dmitrykez/ESP_Damper/README.md

# ESP Damper  
## HVAC Damper Controller

This project is designed to monitor and control HVAC dampers using the **TAC-910 protocol**.  
It utilizes the **ESP32-S2-WROOM** microcontroller, which supports up to 4 RMT channels, allowing control of up to **four dampers**.

---

## 🚀 Key Features

- **Parallel Integration**  
  Hardware connects in parallel with an existing TAC-910 controller.  
  This enables the ESP32 to both **listen to IR commands** received by the TAC-910 and **send its own IR commands**.

- **Multi-Channel IR support**  
  Supports up to 4 IR channels simultaneously using the ESP32 RMT peripheral.
  The FW supports dual device operation to support up to 8 channels, seemlees for Home Assistant.

- **Wi-Fi & MQTT Communication**  
  The ESP32 connects to the home network via Wi-Fi and communicates with **Home Assistant** using the **MQTT protocol**.

- **Web-Based Configuration UI**  
  Built-in Web UI accessible via the device IP address:
  Device name (Wi-Fi and MQTT identification)
    - Wi-Fi credentials
    - MQTT broker address and port
    - Channel group selection (0–3 or 4–7)
    - Basic communication status
    - Firmware update (OTA)
    - Factory reset

---

## ⚙️ Operation Overview

- **Startup**  
  On boot, the controller connects to Wi-Fi and the MQTT broker, then enters RX mode to listen for IR commands on all four RMT channels.

- **IR → MQTT**  
  When an IR command is received, it is parsed and published to Home Assistant via MQTT.

- **MQTT → IR**  
  When an MQTT command is received, it’s converted into the appropriate IR format.  
  The relevant RMT channel switches to TX mode, sends the command to the TAC-910, and then returns to RX mode.

- **OTA Firmware Updates**  
  Firmware can be updated over-the-air (OTA) by accessing the controller through its IP address in a web browser.

- **Factory Reset**  
  Factory reset clears all stored user configuration and restarts the device in Wi-Fi Access Point (AP) mode for initial setup.
  Reset methods:
    - Via Web UI
    - By pressing and holding the Reset button for 5 seconds until the status LED blinks at 1-second intervals

---

## 📦 Modules

- **RX**  
  Listens for IR commands on up to 4 channels using the RMT module.

- **TX**  
  Sends IR commands to the TAC-910 via the RMT module.

- **Wireless**  
  Handles Wi-Fi and MQTT connectivity, as well as Web UI and OTA firmware updates.

- **Helpers**  
  Includes functions and defaults for data parsing and command management.

- **EEPROM**  
  Defined but not currently used.

---

## 📝 TODO
- [ ] Utilize EEPROM to:  
  - [ ] Store the last known configuration for each damper channel.  

## 🛠️ Controller view
