dmitrykez/ESP_Damper/ESP32 Damper.pdf

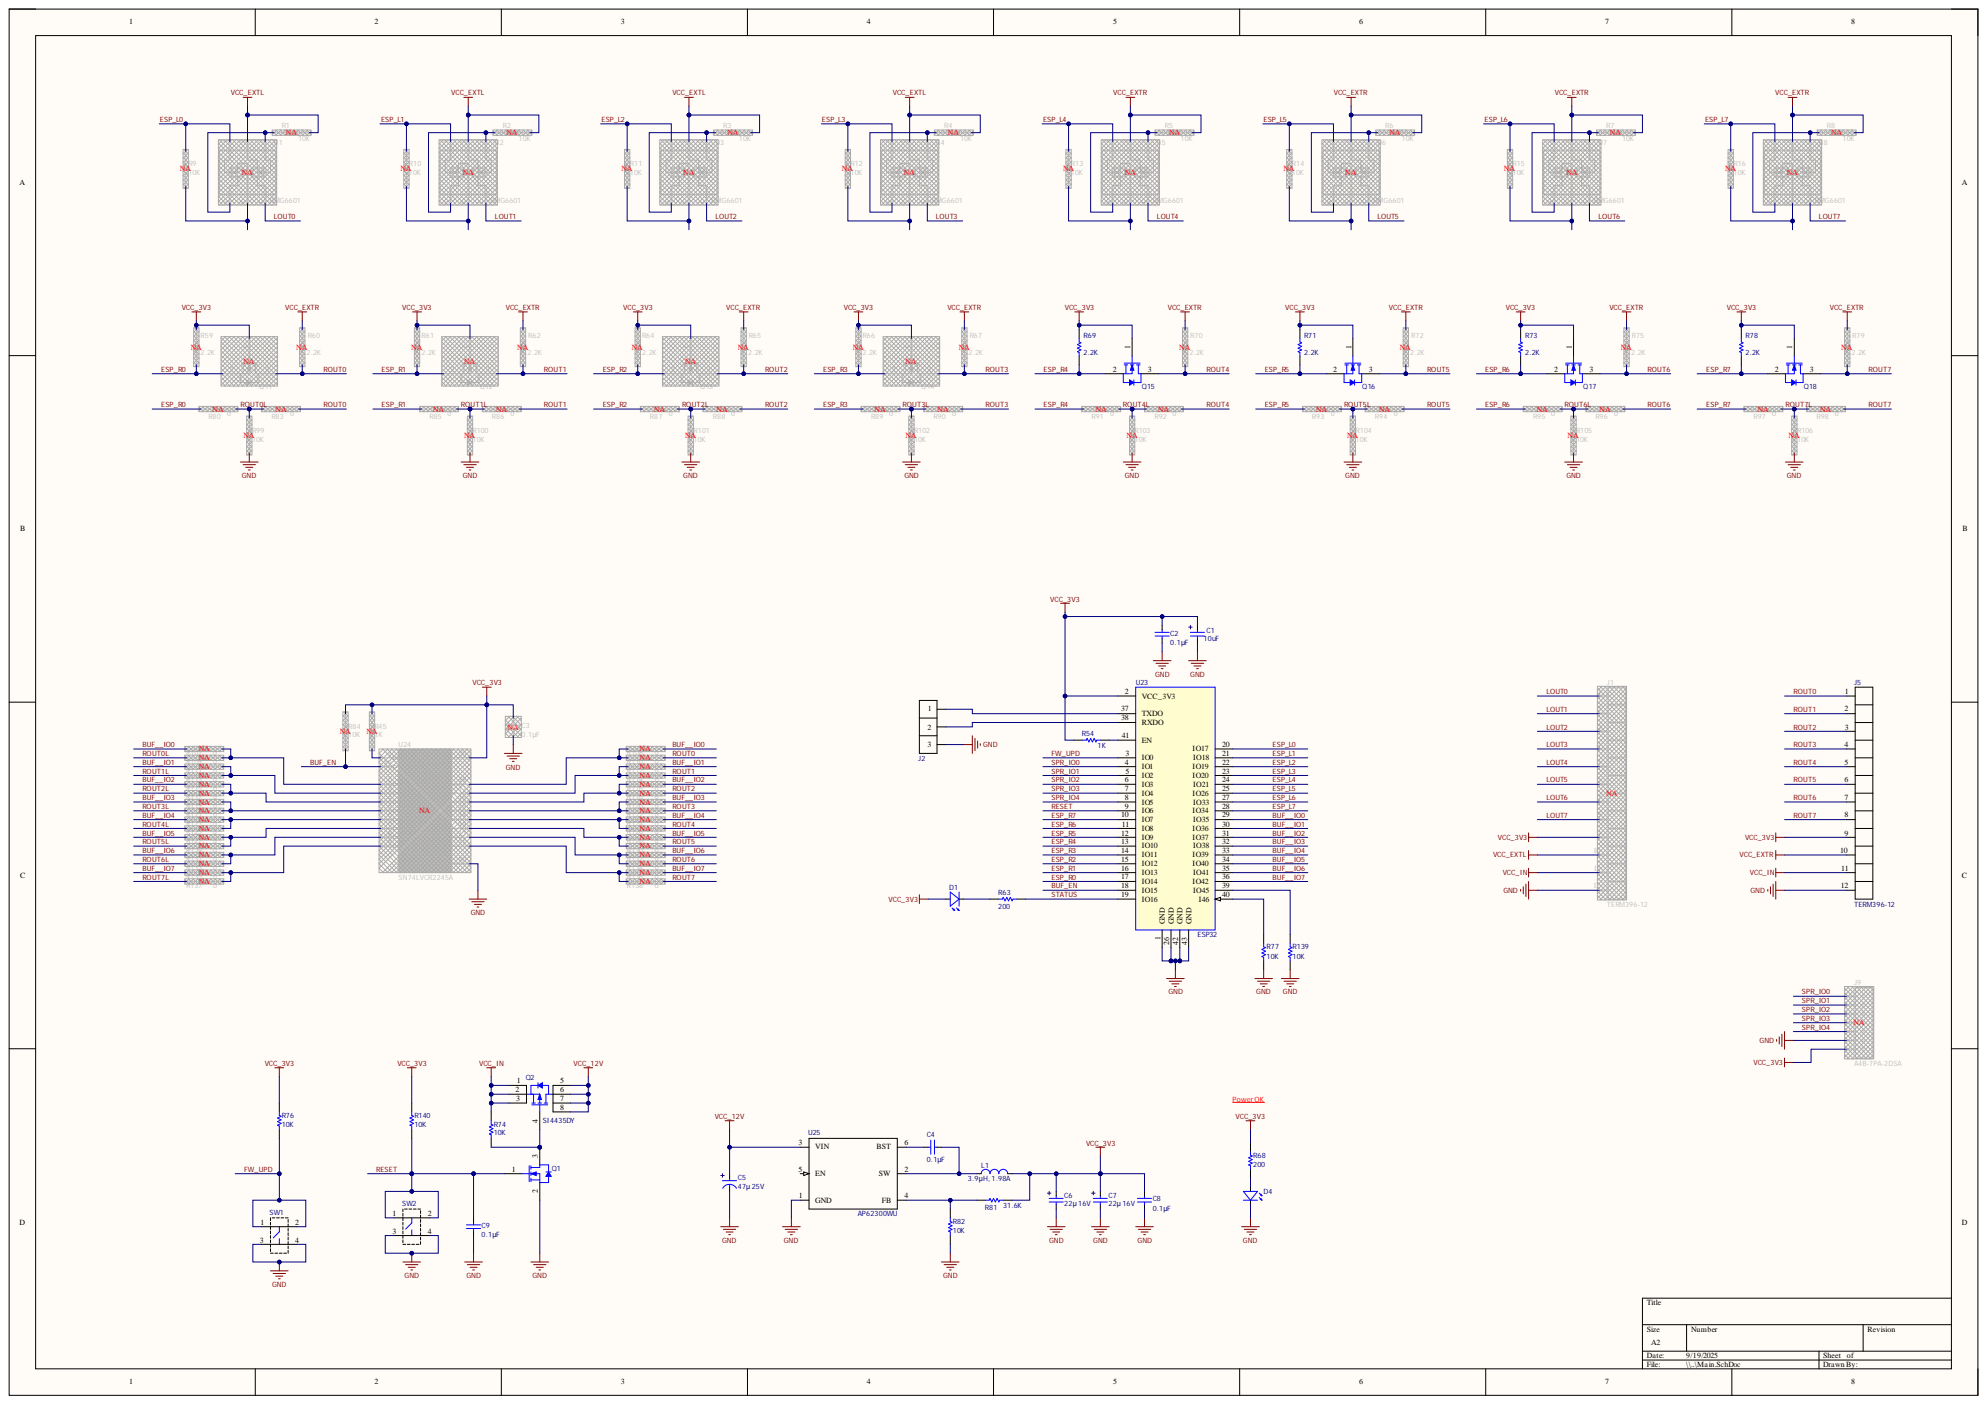
[picture p4: page 1]
