dmitrykez/ESP_Damper/(commit log)

2026-02-13 Added Web UI, factory reset, status LED, multi-device support and user manual
    [config.cpp, config.h, reset.cpp, rxtx_multi_wifi.ino, status_led.cpp, status_led.h]
2026-04-17 Pulse width print fix
    [rxtx_multi_wifi.ino]
